Italiant/FYP/Circuit/RX Final.asc

CH: cap; 1.3µ
Photodiode: current; SINE(0 0.12u 1k)
RF: res; 27Meg
RH: res; 1k
Transimpedance: OPA2380
V1: voltage; 5
V2: voltage; 5
Named nets: 0, +v, -v, Vout
.tran 0 3 0 1
