Italiant/FYP/Circuit/RXV2.asc

C1: cap; 0.1µ
C2: cap; 0.1µ
I1: current; SINE(0 9u 1k)
R1: res; 330k
U1: AD8055an
V1: voltage; 5
V2: voltage; 5
Named nets: 0, +v, -v, vout
.tran 0 3 0 1
