Italiant/FYP/Circuit/Tx Circuit Diagram Draft.asc

9V_Battery: voltage; 9
9V_Battery: voltage; 9
C1: cap; 0.1µ
C2: polcap; 22µ
C3: cap; 0.47µ
C4: polcap; 22µ
C5: cap; 0.47µ
C6: polcap; 10µ
C7: polcap; 10µ
CF: cap; 15p
LED: LED; D_ideal
OP-Amp: opamp2; LMX58_LM2904
Pd: current; 9µ
Q1: npn; BC337-25
R1: res; 100k
RB: res; 4k
RC: res; 100
RF: res; 560k
U1: LT3014B
U2: LT3014B
U3: LTC1044
V2: voltage; SINE(0 5 1000)
Named nets: 0, V+, V-, -V, Vo, 5V, 9V
.tran 0 5 0 1
.model D_ideal D(Ron=0.1n Roff=1G Vfwd=3)
.lib LMx58_LM2904.CIR
LM2940CT-5 5V 1A Low Voltage Dropout Regulator
LM2940CT-5 5V 1A Low Voltage Dropout Regulator
TC1044SEPA Charge Pump Switching Regulator Negative Fixed -Vin
