Italiant/FYP/Circuit/TX FINAL.asc

D1: LED; XPEBGRN
Q1: npn; Q2SCR573D3
R2: res; 200
R: res; 2
V1: voltage; 5
V2: voltage; SINE(0 3.3 1000)
Named nets: 5v, 0
.lib 2scr573d3.lib
.tran 0 5 0 1
