Italiant/FYP/(list of files, drawings)

Other design files:
Circuit/OPA2380_PSPICE_AIO/OPA2380.DSN
Circuit/OPA2380_PSPICE_AIO/OPA2380.OLB
Circuit/OPA2380_PSPICE_AIO/OPA2380.opj
Circuit/RX/OPA2380_PSPICE_AIO/OPA2380.DSN
Circuit/RX/OPA2380_PSPICE_AIO/OPA2380.OLB
Circuit/RX/OPA2380_PSPICE_AIO/OPA2380.opj
