Italiant/FYP/PCB/TX.kicad_pcb

## KiCad design PCB/TX.kicad_pcb (2022-03-25)

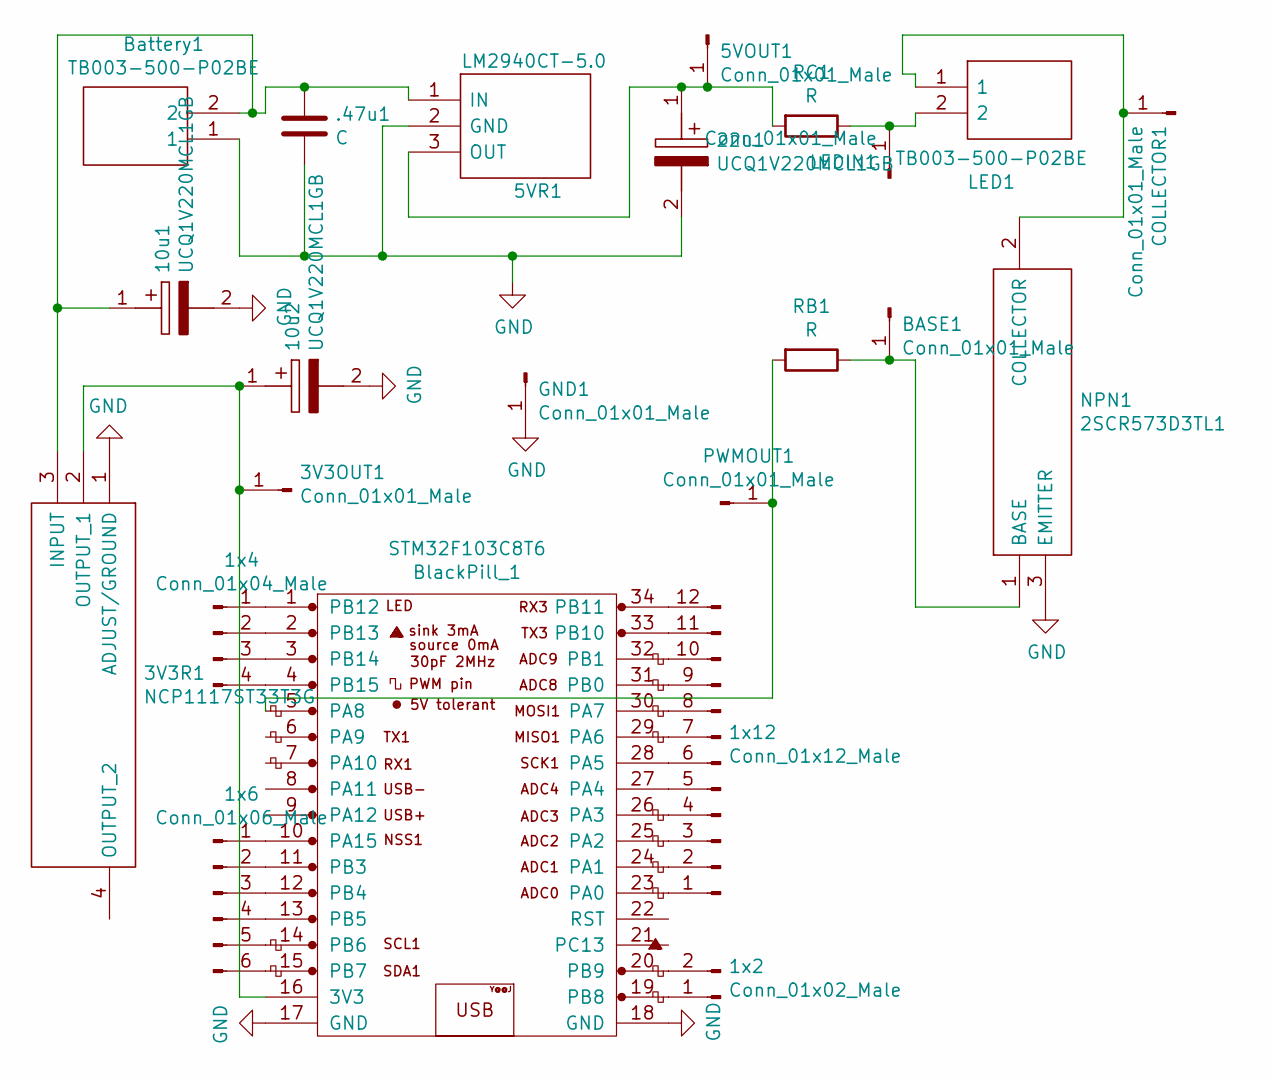
[picture p6: schematic TX.sch]

Parts:
1x2: Conn_01x02_Male; PinHeader_1x02_P2.54mm_Vertical
1x4: Conn_01x04_Male; PinHeader_1x04_P2.54mm_Vertical
1x6: Conn_01x06_Male; PinHeader_1x06_P2.54mm_Vertical
1x12: Conn_01x12_Male; PinHeader_1x12_P2.54mm_Vertical
3V3OUT1, 5VOUT1: Conn_01x01_Male; PinHeader_1x01_P2.54mm_Vertical
3V3R1: NCP1117ST33T3G; SOT230P700X180-4N; Mouser Part Number 863-NCP1117ST33T3G
5VR1: LM2940CT-5.0; TO254P470X1016X2222-3P; Manufacturer_Part_Number LM2940CT-5.0; Mouser Part Number 926-LM2940CT-50
10u1, 10u2, 22u1: UCQ1V220MCL1GB; CAPAE660X530N; Mouser Part Number 647-UCQ1V220MCL1GB
.47u1: C; C_1206_3216Metric_Pad1.33x1.80mm_HandSolder
BASE1: Conn_01x01_Male; PinHeader_1x01_P2.54mm_Vertical
Battery1: TB003-500-P02BE; SHDR2W100P0X500_1X2_1000X780X1030P; Mouser Part Number 490-TB003-500-P02BE
COLLECTOR1: Conn_01x01_Male; PinHeader_1x01_P2.54mm_Vertical
GND1: Conn_01x01_Male; PinHeader_1x01_P2.54mm_Vertical
LED1: TB003-500-P02BE; SHDR2W100P0X500_1X2_1000X780X1030P; Mouser Part Number 490-TB003-500-P02BE
LEDIN1: Conn_01x01_Male; PinHeader_1x01_P2.54mm_Vertical
NPN1: 2SCR573D3TL1; Mouser Part Number 755-2SCR573D3TL1
PWMOUT1: Conn_01x01_Male; PinHeader_1x01_P2.54mm_Vertical
RB1: R; R_1206_3216Metric_Pad1.30x1.75mm_HandSolder
RC1: R; R_1206_3216Metric_Pad1.30x1.75mm_HandSolder
STM32F103C8T6: BlackPill_1; YAAJ_BlackPill

Connections:
GND: 3V3R1.1 (ADJUST/GROUND), 5VR1.2 (GND), 10u1.2, 10u2.2, 22u1.2, .47u1.2, Battery1.1, GND1.1, NPN1.3 (EMITTER), STM32F103C8T6.17 (GND), STM32F103C8T6.18 (GND)
unnamed: 1x2.1, STM32F103C8T6.19 (PB8)
unnamed: 1x2.2, STM32F103C8T6.20 (PB9)
unnamed: 1x4.1, STM32F103C8T6.1 (PB12)
unnamed: 1x4.2, STM32F103C8T6.2 (PB13)
unnamed: 1x4.3, STM32F103C8T6.3 (PB14)
unnamed: 1x4.4, STM32F103C8T6.4 (PB15)
unnamed: 1x6.1, STM32F103C8T6.10 (PA15)
unnamed: 1x6.2, STM32F103C8T6.11 (PB3)
unnamed: 1x6.3, STM32F103C8T6.12 (PB4)
unnamed: 1x6.4, STM32F103C8T6.13 (PB5)
unnamed: 1x6.5, STM32F103C8T6.14 (PB6)
unnamed: 1x6.6, STM32F103C8T6.15 (PB7)
unnamed: 1x12.1, STM32F103C8T6.23 (PA0)
unnamed: 1x12.2, STM32F103C8T6.24 (PA1)
unnamed: 1x12.3, STM32F103C8T6.25 (PA2)
unnamed: 1x12.4, STM32F103C8T6.26 (PA3)
unnamed: 1x12.5, STM32F103C8T6.27 (PA4)
unnamed: 1x12.6, STM32F103C8T6.28 (PA5)
unnamed: 1x12.7, STM32F103C8T6.29 (PA6)
unnamed: 1x12.8, STM32F103C8T6.30 (PA7)
unnamed: 1x12.9, STM32F103C8T6.31 (PB0)
unnamed: 1x12.10, STM32F103C8T6.32 (PB1)
unnamed: 1x12.11, STM32F103C8T6.33 (PB10)
unnamed: 1x12.12, STM32F103C8T6.34 (PB11)
unnamed: 3V3OUT1.1, 3V3R1.2 (OUTPUT_1), 10u2.1, STM32F103C8T6.16 (3V3)
unnamed: 5VOUT1.1, 5VR1.3 (OUT), 22u1.1, RC1.2
unnamed: 3V3R1.3 (INPUT), 5VR1.1 (IN), 10u1.1, .47u1.1, Battery1.2
unnamed: BASE1.1, NPN1.1 (BASE), RB1.1
unnamed: COLLECTOR1.1, LED1.1, NPN1.2 (COLLECTOR)
unnamed: LED1.2, LEDIN1.1, RC1.1
unnamed: PWMOUT1.1, RB1.2, STM32F103C8T6.5 (PA8)

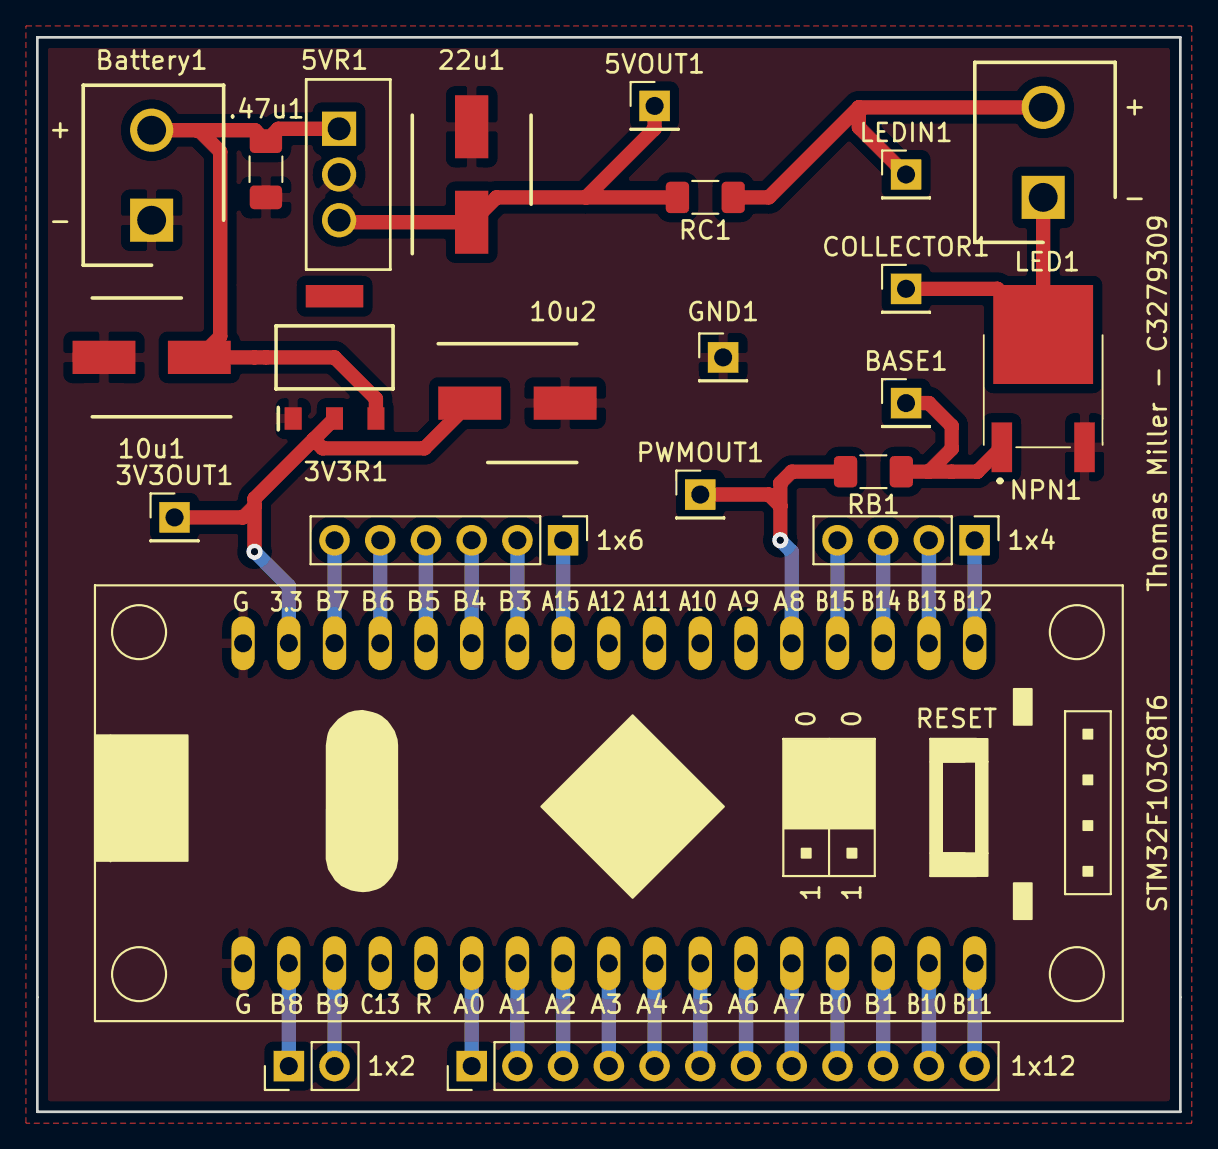
[picture p7: board TX.kicad_pcb from above]

Board: 2 copper layers, 63.5 x 59.7 mm, 23 parts (0 on the bottom side), 32 nets.
