Italiant/FYP/PCB/LED.kicad_pcb

## KiCad design PCB/LED.kicad_pcb (2022-03-25)

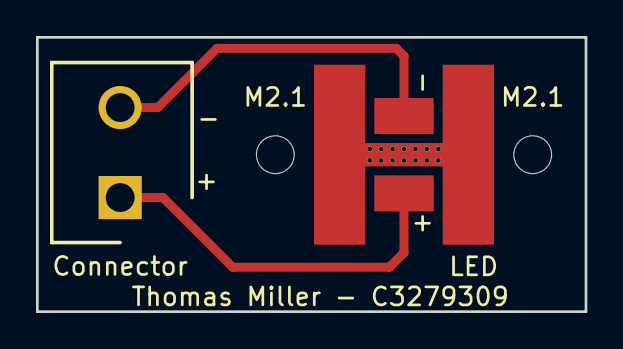
[picture p8: board LED.kicad_pcb from above]

Board: 2 copper layers, 30.5 x 15.2 mm, 4 parts (0 on the bottom side), 2 nets.

Parts:
Connector: TB003-500-P02BE-SamacSys_Parts; SHDR2W100P0X500_1X2_1000X780X1030P
LED: XPEBGR-L1-0000-00G03-SamacSys_Parts; LED_Thermal
M2.1, M2.1#2: MountingHole_2.1mm

Connections:
unnamed: Connector.1, LED.2
unnamed: Connector.2, LED.1
