Italiant/FYP/PCB/RX.kicad_pcb

## KiCad design PCB/RX.kicad_pcb (2022-03-25)

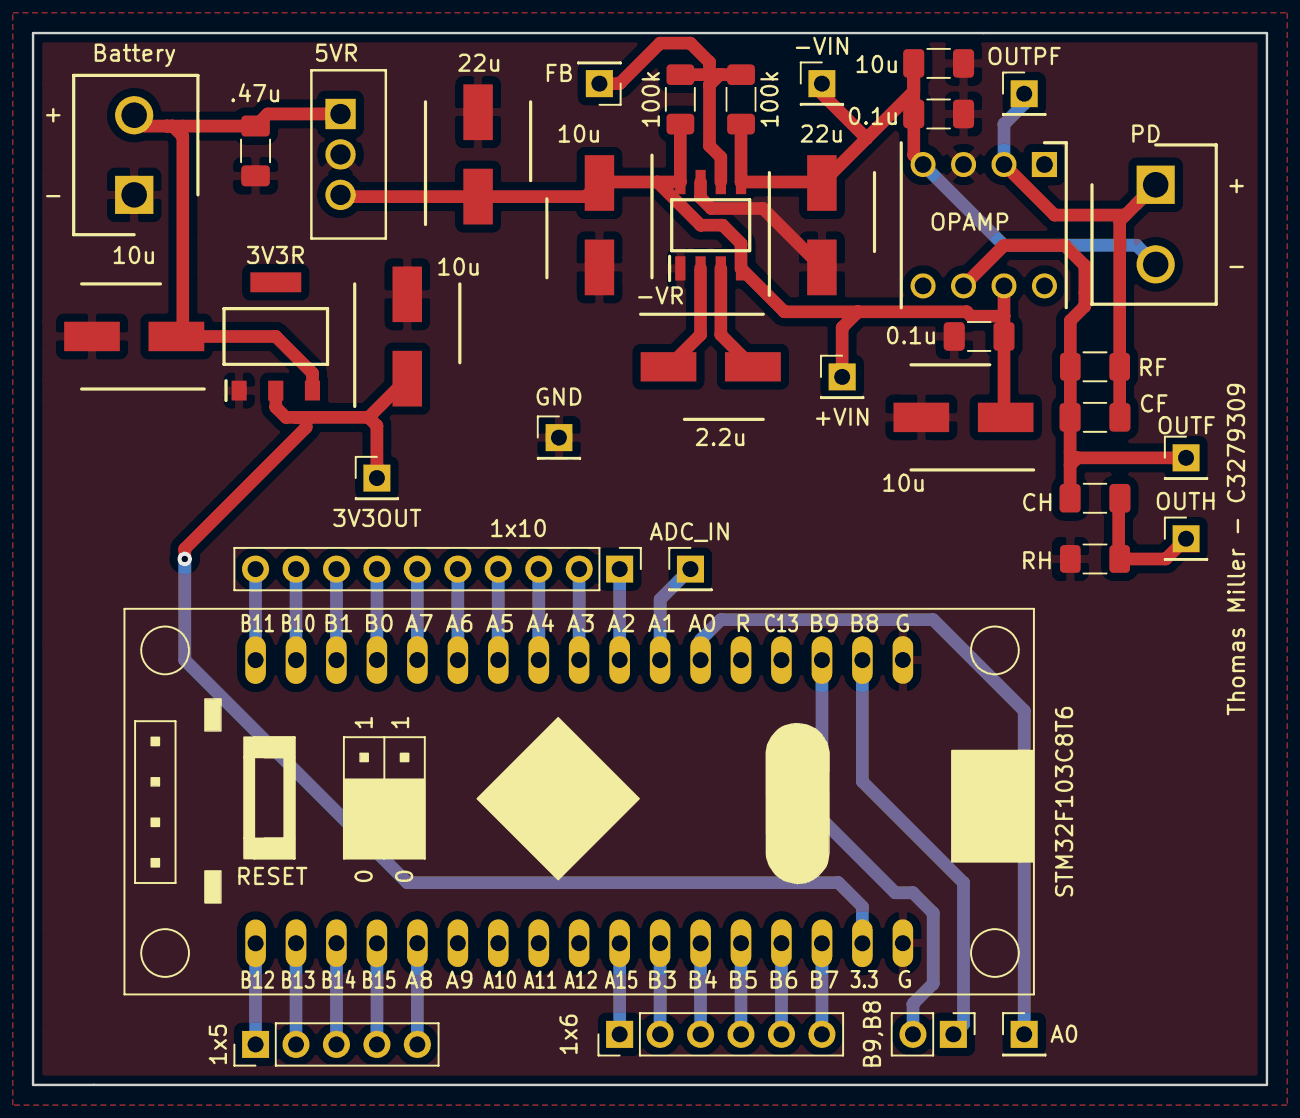
[picture p9: board RX.kicad_pcb from above]

Board: 2 copper layers, 77.5 x 66.0 mm, 38 parts (0 on the bottom side), 36 nets.

Parts:
0.1u, 0.1u#2, 10u#5, .47u: C; C_1206_3216Metric_Pad1.33x1.80mm_HandSolder
1x5: Conn_01x05_Male; PinHeader_1x05_P2.54mm_Vertical
1x6: Conn_01x06_Male; PinHeader_1x06_P2.54mm_Vertical
1x10: Conn_01x10_Male; PinHeader_1x10_P2.54mm_Vertical
2.2u, 10u, 10u#2, 10u#3, 10u#4, 22u, 22u#2: UCQ1V220MCL1GB; CAPAE660X530N
3V3OUT: Conn_01x01_Male; PinHeader_1x01_P2.54mm_Vertical
3V3R: NCP1117ST33T3G; SOT230P700X180-4N
5VR: LM2940CT-5.0; TO254P470X1016X2222-3P
100k, 100k#2: R; R_1206_3216Metric_Pad1.30x1.75mm_HandSolder
+VIN: Conn_01x01_Male; PinHeader_1x01_P2.54mm_Vertical
-VIN: Conn_01x01_Male; PinHeader_1x01_P2.54mm_Vertical
-VR: MAX1673ESA+; SOIC127P600X175-8N
A0: Conn_01x01_Male; PinHeader_1x01_P2.54mm_Vertical
ADC_IN: Conn_01x01_Male; PinHeader_1x01_P2.54mm_Vertical
B9,B8: Conn_01x02_Male; PinHeader_1x02_P2.54mm_Vertical
Battery: TB003-500-P02BE; SHDR2W100P0X500_1X2_1000X780X1030P
CF: C; C_1206_3216Metric_Pad1.33x1.80mm_HandSolder
CH: C; C_1206_3216Metric_Pad1.33x1.80mm_HandSolder
FB: Conn_01x01_Male; PinHeader_1x01_P2.54mm_Vertical
GND: Conn_01x01_Male; PinHeader_1x01_P2.54mm_Vertical
OPAMP: AD8055ANZ; DIPS762W61P254L1016H525Q8N
OUTF: Conn_01x01_Male; PinHeader_1x01_P2.54mm_Vertical
OUTH: Conn_01x01_Male; PinHeader_1x01_P2.54mm_Vertical
OUTPF: Conn_01x01_Male; PinHeader_1x01_P2.54mm_Vertical
PD: TB003-500-P02BE; SHDR2W100P0X500_1X2_1000X780X1030P
RF: R; R_1206_3216Metric_Pad1.30x1.75mm_HandSolder
RH: R; R_1206_3216Metric_Pad1.30x1.75mm_HandSolder
STM32F103C8T6: BlackPill_1; YAAJ_BlackPill

Connections:
GND: 0.1u.2, 0.1u#2.1, 3V3R.1, 5VR.2, 10u.2, 10u#2.2, 10u#3.2, 10u#4.2, 10u#5.1, 22u.2, 22u#2.1, -VR.1, -VR.7, .47u.1, Battery.1, GND.1, OPAMP.3, RH.2, STM32F103C8T6.17, STM32F103C8T6.18
unnamed: 1x5.1, STM32F103C8T6.1
unnamed: 1x5.2, STM32F103C8T6.2
unnamed: 1x5.3, STM32F103C8T6.3
unnamed: 1x5.4, STM32F103C8T6.4
unnamed: 1x5.5, STM32F103C8T6.5
unnamed: 1x6.1, STM32F103C8T6.10
unnamed: 1x6.2, STM32F103C8T6.11
unnamed: 1x6.3, STM32F103C8T6.12
unnamed: 1x6.4, STM32F103C8T6.13
unnamed: 1x6.5, STM32F103C8T6.14
unnamed: 1x6.6, STM32F103C8T6.15
unnamed: 1x10.1, STM32F103C8T6.25
unnamed: 1x10.2, STM32F103C8T6.26
unnamed: 1x10.3, STM32F103C8T6.27
unnamed: 1x10.4, STM32F103C8T6.28
unnamed: 1x10.5, STM32F103C8T6.29
unnamed: 1x10.6, STM32F103C8T6.30
unnamed: 1x10.7, STM32F103C8T6.31
unnamed: 1x10.8, STM32F103C8T6.32
unnamed: 1x10.9, STM32F103C8T6.33
unnamed: 1x10.10, STM32F103C8T6.34
unnamed: 2.2u.1, -VR.2
unnamed: 2.2u.2, -VR.3
unnamed: 3V3OUT.1, 3V3R.2, 10u#2.1, STM32F103C8T6.16
unnamed: 100k.2, 100k#2.1, -VR.6, FB.1
unnamed: 0.1u.1, 5VR.3, 10u#3.1, 10u#4.1, 22u.1, 100k.1, +VIN.1, -VR.4, -VR.8, OPAMP.7
unnamed: 0.1u#2.2, 10u#5.2, 22u#2.2, 100k#2.2, -VIN.1, -VR.5, OPAMP.4, PD.2
unnamed: 3V3R.3, 5VR.1, 10u.1, .47u.2, Battery.2
unnamed: A0.1, STM32F103C8T6.23
unnamed: ADC_IN.1, STM32F103C8T6.24
unnamed: B9,B8.1, STM32F103C8T6.19
unnamed: B9,B8.2, STM32F103C8T6.20
unnamed: CF.1, OPAMP.2, OUTPF.1, PD.1, RF.1
unnamed: CF.2, CH.2, OPAMP.6, OUTF.1, RF.2
unnamed: CH.1, OUTH.1, RH.1
