Italiant/FYP/Code/Receiver/Core/Src/main.c

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
/* Includes ------------------------------------------------------------------*/
#include "main.h"
#include "usb_device.h"

TIM_HandleTypeDef htim2;

/* USER CODE BEGIN PV */

int g_TIMCALLBACK;//[8];

int i = 0;
int k = 0;
char Msg[200] = "hello hello hello hello hello hello hello hello hello hello hello hello hello hello hello \r\n";
char binaryString[8] = "";
char endString[] = "00000000";
int bytes = 0;
int wait = 0;
char c;
int pulse_delay = 7;

/* USER CODE END PV */

void SystemClock_Config(void);
static void MX_GPIO_Init(void);
static void MX_TIM2_Init(void);
/**
 * @brief  The application entry point.
 * @retval int
 */
int main(void)
{
	/* MCU Configuration--------------------------------------------------------*/

	/* Reset of all peripherals, Initializes the Flash interface and the Systick. */
	HAL_Init();

	/* Configure the system clock */
	SystemClock_Config();

	/* Initialize all configured peripherals */
	MX_GPIO_Init();
	MX_USB_DEVICE_Init();
	MX_TIM2_Init();
	/* USER CODE BEGIN 2 */

	HAL_GPIO_WritePin(LED_GPIO_Port, LED_Pin, GPIO_PIN_SET);

	/* USER CODE END 2 */

	/* Infinite loop */
	/* USER CODE BEGIN WHILE */
	while (1)
	{
		/* USER CODE END WHILE */

		/* USER CODE BEGIN 3 */
	}

	/* USER CODE END 3 */
}

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
/* USER CODE BEGIN 4 */

void HAL_GPIO_EXTI_Callback(uint16_t GPIO_Pin) // trigger once when the first rising edge of the first bit of the start flag is detected
{
	if(GPIO_Pin == TRIG_Pin) // check that it has been called on the right pin
	{
		HAL_TIM_Base_Start_IT(&htim2); // start the timer
		HAL_NVIC_DisableIRQ(EXTI15_10_IRQn); // disable this trigger
		HAL_GPIO_WritePin(LED_GPIO_Port, LED_Pin, GPIO_PIN_RESET); // turn on the blue on board LED to signal that data is now being sampled
	}
}

// Callback: timer has rolled over
void HAL_TIM_PeriodElapsedCallback(TIM_HandleTypeDef *htim)
{
	if ( htim == &htim2 ) // triggers every 0.5ms
	{
		if( k == 0 )
		{
			sprintf(Msg, "Incoming Transmission:\r\n"); // visual to tell user that the program has started recording data
			CDC_Transmit_FS(Msg, strlen(Msg)); // prints to putty
			k = 1;
		}

		if( wait < pulse_delay ) // initially 7 then 1 then 9 then 1 then 9....
		{
			wait++;
			//HAL_GPIO_WritePin(GPIOB, GPIO_PIN_14, GPIO_PIN_RESET); // uncomment to visually see when timer is sampling

		} else { // record data

			//HAL_GPIO_WritePin(GPIOB, GPIO_PIN_14, GPIO_PIN_SET); // uncomment to visually see when timer is sampling

			// check if the input voltage is above approximately 1.2V to record a HIGH (1), or less than that to record a LOW (0)
			g_TIMCALLBACK = HAL_GPIO_ReadPin(test_GPIO_Port, test_Pin);

			binaryString[i] = g_TIMCALLBACK +'0'; // simple trick to convert an int to a char

			i++;

			// reset pulse delay and set delay to 1 cycle to sample in the exact middle of each incoming pulse
			wait = 0;
			pulse_delay = 1;

			if(i == 8)
			{
				// uncomment to end the transmission after 8 zeros are detected in a line (endString = '00000000')
				//if(strcmp(binaryString, endString) == 0)
				//{
				//	sprintf(Msg, "\r\nTransmission Ended.\r\n");
				//	CDC_Transmit_FS(Msg, strlen(Msg));
				//HAL_TIM_Base_Stop_IT(&htim2);
				//}
				//else
				//{
				c = strtol(binaryString, 0, 2); // method to convert the first 8 positions in the integer binarystring array to a character
				if(bytes == 11) // used to print the next entire transmission to a new line
				{
					sprintf(Msg, "%c\r\n", c);
					CDC_Transmit_FS(Msg, strlen(Msg));
					bytes = 0;
				}
				else
				{
					sprintf(Msg, "%c", c); // prints one character at a time
					CDC_Transmit_FS(Msg, strlen(Msg));
					bytes++;
				}

				i = 0;

				wait = 0; // reset pulse delay and set delay to 9 cycles to incorporate both the start and end flags
				pulse_delay = 9;
				//}
			}
		}
	}
}

/* USER CODE END 4 */
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
