Italiant/FYP/Code/Receiver/Core/Inc/main.h

#define LED_Pin GPIO_PIN_12
#define LED_GPIO_Port GPIOB
#define TRIG_Pin GPIO_PIN_15
#define TRIG_GPIO_Port GPIOB
#define TRIG_EXTI_IRQn EXTI15_10_IRQn
#define test_Pin GPIO_PIN_3
#define test_GPIO_Port GPIOB
